SreeniEadara/Hopkins-iGEM-2022-electrical/iGEM.png

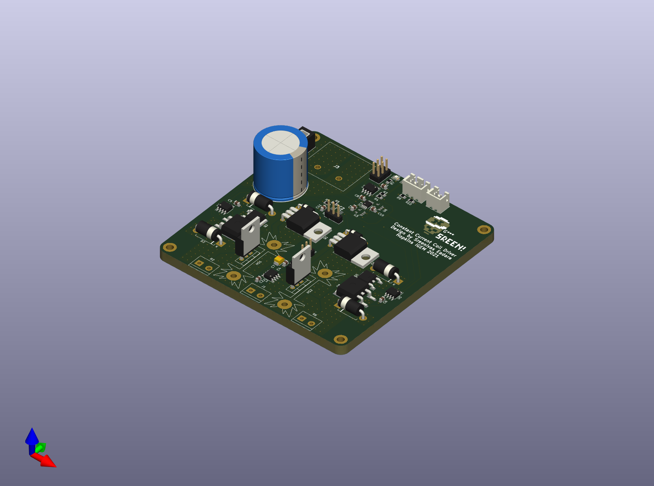
iGEM.png
