SreeniEadara/Hopkins-iGEM-2022-electrical/ConstantCurrentBoard.step

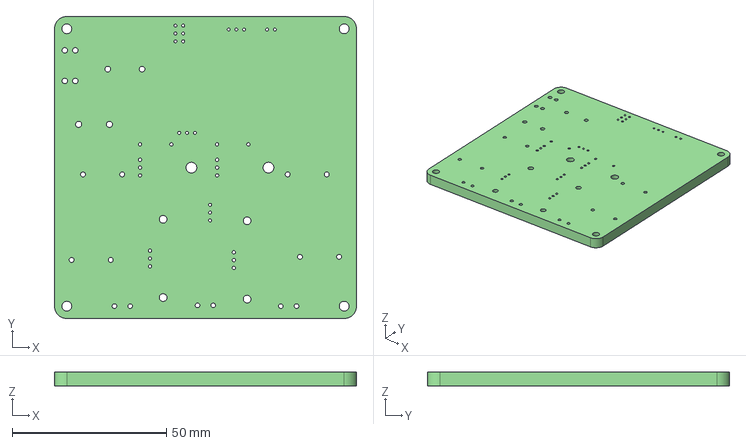
[picture p2: CAD file, 2022-08-01]
ConstantCurrentBoard.step
98.0 x 98.0 x 4.69 mm
