SreeniEadara/Hopkins-iGEM-2022-electrical/iGEM.kicad_pcb

## KiCad design iGEM.kicad_pcb (2022-09-10)

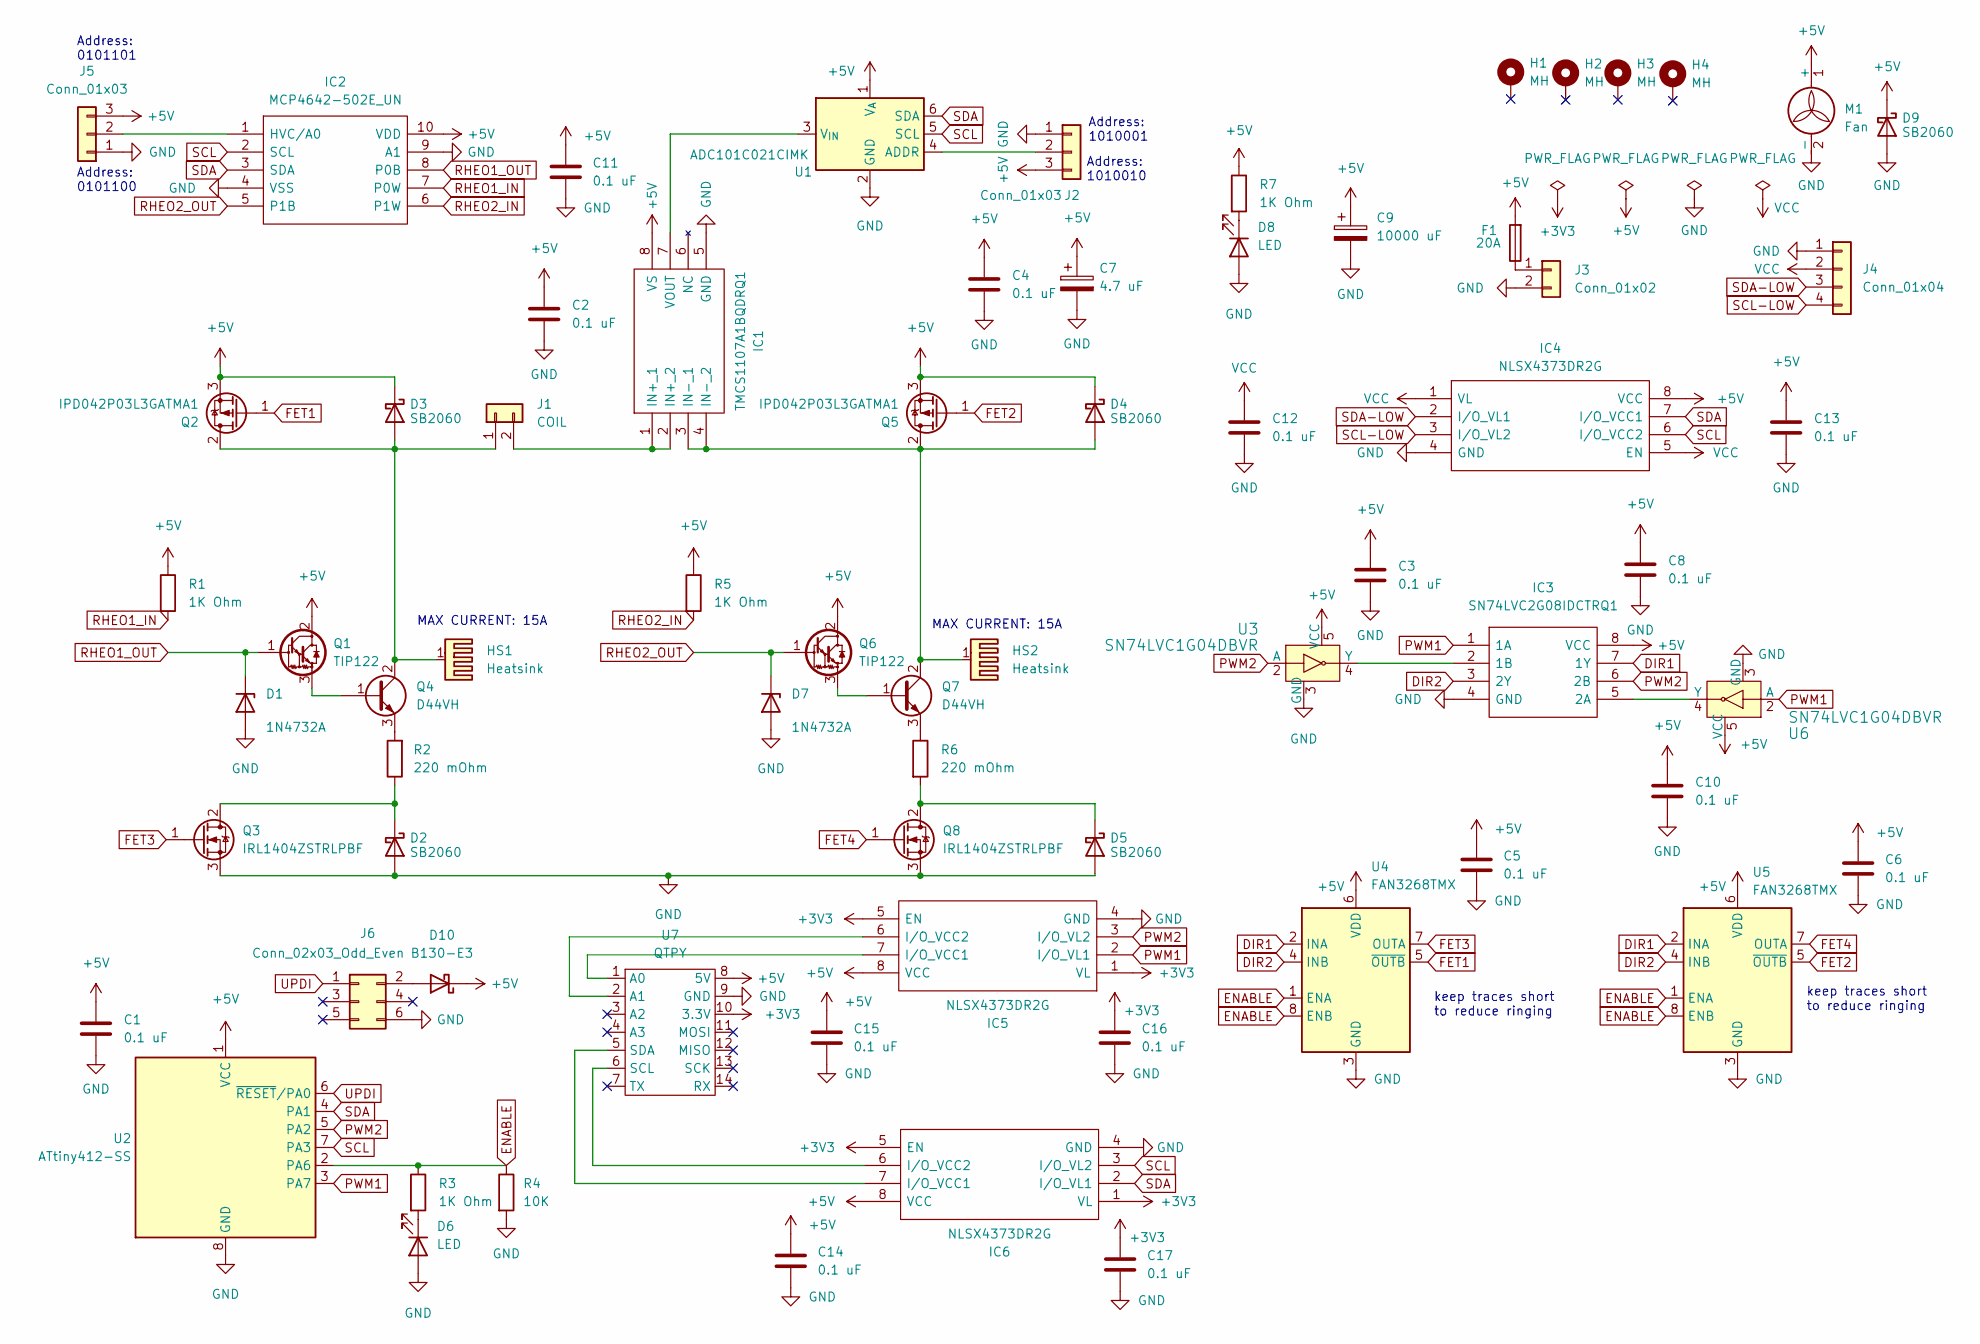
[picture p3: schematic iGEM.kicad_sch]

Parts:
C1, C2, C3, C4, C5, C6, C8, C10, C11, C12, C13, C14, C15, C16, C17: 0.1 uF; C_0805_2012Metric_Pad1.18x1.45mm_HandSolder; DigiKey 399-C0805C104K8RAC7800CT-ND
C7: 4.7 uF; CP_EIA-3528-21_Kemet-B_Pad1.50x2.35mm_HandSolder; DigiKey 399-3723-1-ND
C9: 10000 uF; CP_Radial_D22.0mm_P10.00mm_SnapIn; DigiKey 399-ELG109M025AQ4AA-ND
D1, D7: 1N4732A; D_DO-41_SOD81_P10.16mm_Horizontal; DigiKey 1N4732AFSCT-ND
D2, D3, D4, D5, D9: SB2060; D_DO-201AD_P12.70mm_Horizontal; DigiKey 1655-SB2060CT-ND
D6, D8: LED; LED_0805_2012Metric_Pad1.15x1.40mm_HandSolder; DigiKey 475-1410-1-ND
D10: B130-E3; D_SMA; DigiKey B130-E3/5ATGICT-ND
F1: 20A; Fuseholder_Blade_Mini_Keystone_3568; DigiKey 36-3568-15-ND
H1, H2, H3, H4: MH; MountingHole_3.2mm_M3_DIN965_Pad
HS1, HS2: Heatsink; Heatsink_Fischer_SK104-STC-STIC_35x13mm_2xDrill2.5mm; DigiKey HS403-ND
IC1: TMCS1107A1BQDRQ1; SOIC-8_3.9x4.9mm_P1.27mm; Manufacturer_Part_Number TMCS1107A1BQDRQ1; DigiKey 296-TMCS1107A1BQDRQ1CT-ND
IC2: MCP4642-502E_UN; SOP50P490X110-10N; Manufacturer_Part_Number MCP4642-502E/UN; Mouser Part Number 579-MCP4642-502E/UN
IC3: SN74LVC2G08IDCTRQ1; MSOP-8_3x3mm_P0.65mm; Manufacturer_Part_Number SN74LVC2G08IDCTRQ1; Mouser Part Number 595-SN74LVC2G08IDCQ1
IC4, IC5, IC6: NLSX4373DR2G; SOIC-8_3.9x4.9mm_P1.27mm; Manufacturer_Part_Number NLSX4373DR2G; Mouser Part Number 863-NLSX4373DR2G
J1: COIL; TerminalBlock_bornier-2_P5.08mm; DigiKey 102-6218-ND
J2, J5: Conn_01x03; PinHeader_1x03_P2.54mm_Vertical
J3: Conn_01x02; 8PCV02006; DigiKey A98460-ND
J4: Conn_01x04; JST_XH_B4B-XH-A_1x04_P2.50mm_Vertical; DigiKey 455-2249-ND
J6: Conn_02x03_Odd_Even; PinHeader_2x03_P2.54mm_Vertical
M1: Fan; JST_XH_B2B-XH-A_1x02_P2.50mm_Vertical; DigiKey 455-2879-ND
Q1, Q6: TIP122; TO-220-3_Horizontal_TabDown; DigiKey TIP122GOS-ND
Q2, Q5: IPD042P03L3GATMA1; TO-252-2; DigiKey IPD042P03L3GATMA1CT-ND
Q3, Q8: IRL1404ZSTRLPBF; TO-263-2; DigiKey IRL1404ZSTRLPBFCT-ND
Q4, Q7: D44VH; TO-220-3_Vertical; DigiKey D44VH10GOS-ND
R1, R3, R5, R7: 1K Ohm; R_0805_2012Metric_Pad1.20x1.40mm_HandSolder; DigiKey CHP0805-FX-1001ELFCT-ND
R2, R6: 220 mOhm; TerminalBlock_bornier-2_P5.08mm; DigiKey A102180-ND
R4: 10K; R_0805_2012Metric_Pad1.20x1.40mm_HandSolder; DigiKey RMCF0805FT10K0CT-ND
U1: ADC101C021CIMK; SOT-23-6; DigiKey ADC101C021CIMK/NOPBCT-ND
U2: ATtiny412-SS; SOIC-8_3.9x4.9mm_P1.27mm; DigiKey ATTINY412-SSN-ND
U3, U6: SN74LVC1G04DBVR; SOT-753; MPN SN74LVC1G04DBVR; Digi-Key_PN 296-11599-1-ND
U4, U5: FAN3268TMX; SOIC-8_3.9x4.9mm_P1.27mm; DigiKey FAN3268TMXCT-ND
U7: QTPY; QTPY-RP2040

Connections:
+3V3: C16.1, C17.1, IC5.1 (VL), IC5.5 (EN), IC6.1 (VL), IC6.5 (EN), U7.10 (3.3V)
+5V: C1.1, C2.1, C3.1, C4.1, C5.1, C6.1, C7.1, C8.1, C9.1, C10.1, C11.1, C13.1, C14.1, C15.1, D3.1 (K), D4.1 (K), D9.1 (K), D10.1 (K), F1.2, IC1.8 (VS), IC2.10 (VDD), IC3.8 (VCC), IC4.8 (VCC), IC5.8 (VCC), IC6.8 (VCC), J2.3, J5.3, M1.1 (+), Q1.2 (C), Q2.3 (S), Q5.3 (S), Q6.2 (C), R1.1, R5.1, R7.1, U1.1 (V_{A}), U2.1 (VCC), U3.5 (VCC), U4.6 (VDD), U5.6 (VDD), U6.5 (VCC), U7.8 (5V)
DIR1: IC3.7 (1Y), U4.2 (INA), U5.2 (INA)
DIR2: IC3.3 (2Y), U4.4 (INB), U5.4 (INB)
ENABLE: R3.1, R4.1, U2.2 (PA6), U4.1 (ENA), U4.8 (ENB), U5.1 (ENA), U5.8 (ENB)
FET1: Q2.1 (G), U4.5 (~OUTB)
FET2: Q5.1 (G), U5.5 (~OUTB)
FET3: Q3.1 (G), U4.7 (OUTA)
FET4: Q8.1 (G), U5.7 (OUTA)
GND: C1.2, C2.2, C3.2, C4.2, C5.2, C6.2, C7.2, C8.2, C9.2, C10.2, C11.2, C12.2, C13.2, C14.2, C15.2, C16.2, C17.2, D1.2 (A), D2.2 (A), D5.2 (A), D6.2 (A), D7.2 (A), D8.2 (A), D9.2 (A), IC1.5 (GND), IC2.4 (VSS), IC2.9 (A1), IC3.4 (GND), IC4.4 (GND), IC5.4 (GND), IC6.4 (GND), J2.1, J3.2, J4.1, J5.1, J6.6, M1.2 (-), Q3.3 (S), Q8.3 (S), R4.2, U1.2 (GND), U2.8 (GND), U3.3 (GND), U4.3 (GND), U5.3 (GND), U6.3 (GND), U7.9 (GND)
unnamed: D2.1 (K), Q3.2 (D), R2.1
unnamed: D3.2 (A), HS1.1, J1.1, Q2.2 (D), Q4.2 (C)
unnamed: D4.2 (A), HS2.1, IC1.3 (IN-_1), IC1.4 (IN-_2), Q5.2 (D), Q7.2 (C)
unnamed: D5.1 (K), Q8.2 (D), R6.2
unnamed: D6.1 (K), R3.2
unnamed: D8.1 (K), R7.2
unnamed: D10.2 (A), J6.2
unnamed: F1.1, J3.1
unnamed: IC1.1 (IN+_1), IC1.2 (IN+_2), J1.2
unnamed: IC1.7 (VOUT), U1.3 (V_{IN})
unnamed: IC2.1 (HVC/A0), J5.2
unnamed: IC3.2 (1B), U3.4 (Y)
unnamed: IC3.5 (2A), U6.4 (Y)
unnamed: IC5.6 (I/O_VCC2), U7.2 (A1)
unnamed: IC5.7 (I/O_VCC1), U7.1 (A0)
unnamed: IC6.6 (I/O_VCC2), U7.6 (SCL)
unnamed: IC6.7 (I/O_VCC1), U7.5 (SDA)
unnamed: J2.2, U1.4 (ADDR)
unnamed: Q1.3 (E), Q4.1 (B)
unnamed: Q4.3 (E), R2.2
unnamed: Q6.3 (E), Q7.1 (B)
unnamed: Q7.3 (E), R6.1
PWM1: IC3.1 (1A), IC5.2 (I/O_VL1), U2.3 (PA7), U6.2 (A)
PWM2: IC3.6 (2B), IC5.3 (I/O_VL2), U2.5 (PA2), U3.2 (A)
RHEO1_IN: IC2.7 (P0W), R1.2
RHEO1_OUT: D1.1 (K), IC2.8 (P0B), Q1.1 (B)
RHEO2_IN: IC2.6 (P1W), R5.2
RHEO2_OUT: D7.1 (K), IC2.5 (P1B), Q6.1 (B)
SCL: IC2.2 (SCL), IC4.6 (I/O_VCC2), IC6.3 (I/O_VL2), U1.5 (SCL), U2.7 (PA3)
SCL-LOW: IC4.3 (I/O_VL2), J4.4
SDA: IC2.3 (SDA), IC4.7 (I/O_VCC1), IC6.2 (I/O_VL1), U1.6 (SDA), U2.4 (PA1)
SDA-LOW: IC4.2 (I/O_VL1), J4.3
UPDI: J6.1, U2.6 (~RESET/PA0)
VCC: C12.1, IC4.1 (VL), IC4.5 (EN), J4.2

Notes on the sheet:
Address: 0101101
MAX CURRENT: 15A
keep traces short to reduce ringing
Address: 1010001
Address: 1010010
Address: 0101100

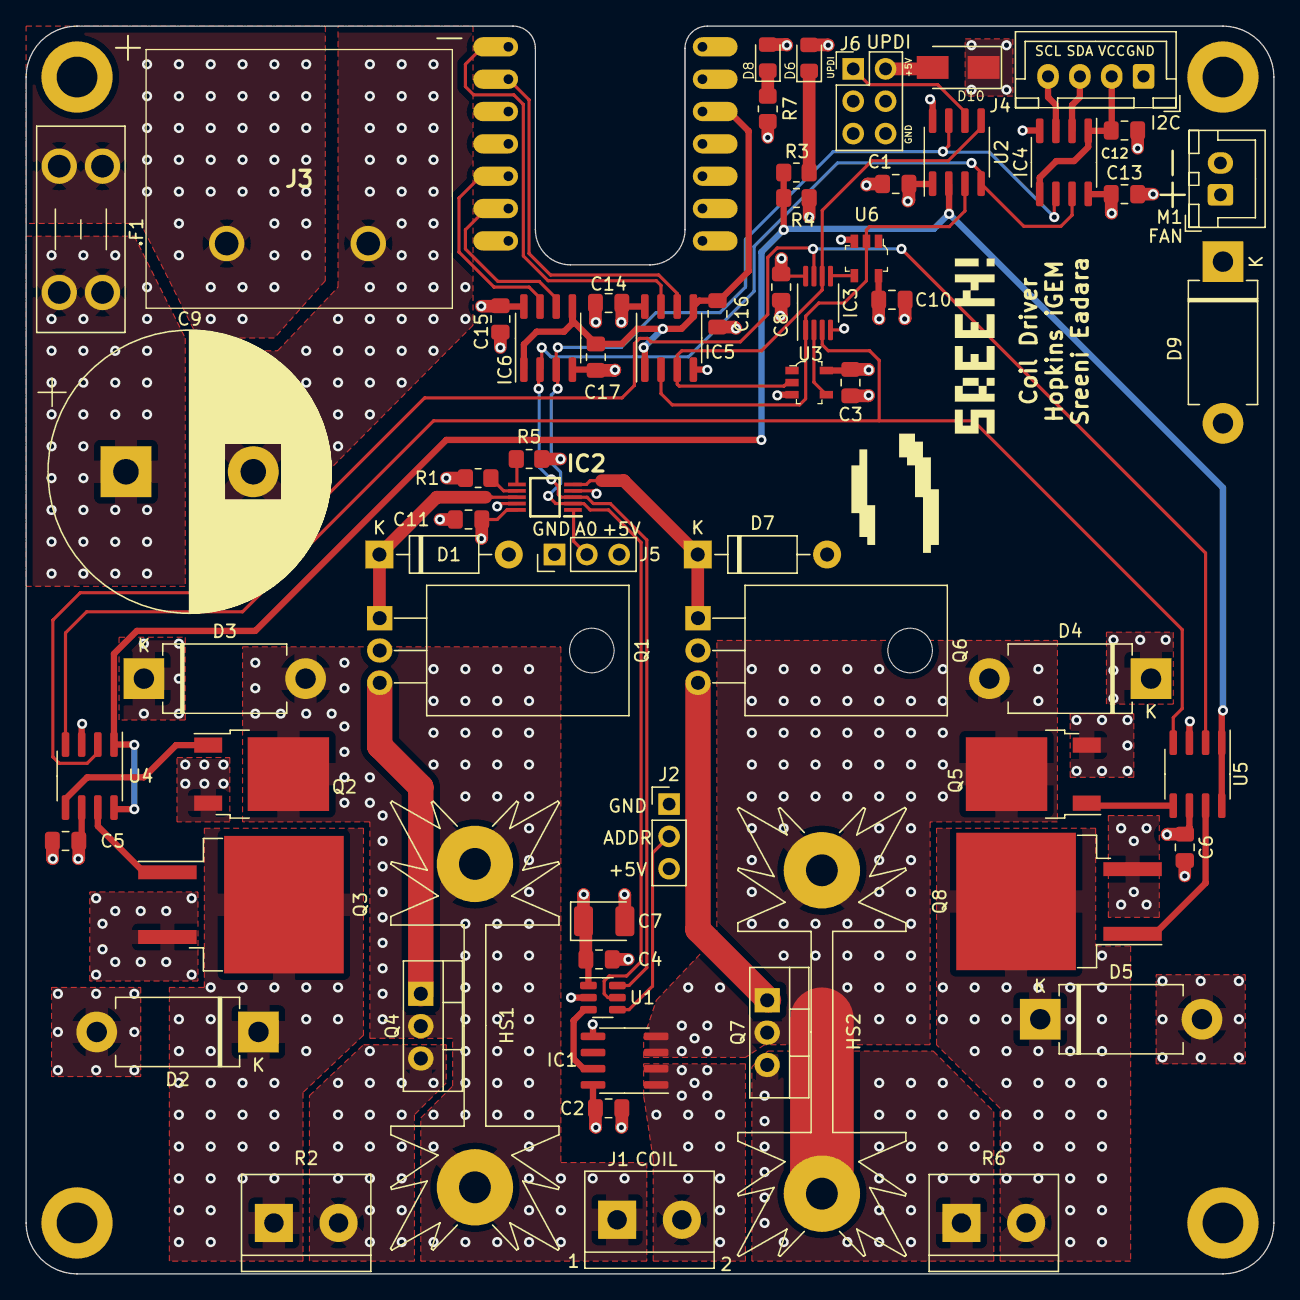
[picture p4: board iGEM.kicad_pcb from above]

Board: 4 copper layers, 98.0 x 98.0 mm, 69 parts (0 on the bottom side), 44 nets.
