SreeniEadara/Hopkins-iGEM-2022-electrical/(commit log)

2022-06-11 initial commit. Schematic not yet complete
    [iGEM.kicad_pcb, iGEM.kicad_sch]
2022-06-11 updated schematic. Added symbols for Adafruit Trinket
    [iGEM.kicad_sch]
2022-07-04 Updated schematic using simulation results and common resistor values. Now using an NPN darlington to drive a D44VH
    [iGEM.kicad_sch]
2022-07-04 changes made to satisfy ERC
    [iGEM.kicad_sch]
2022-07-05 Schematics capture complete. Added footprints and DigiKey part numbers
    [iGEM.kicad_pcb, iGEM.kicad_sch]
2022-07-05 layout draft complete
    [iGEM.kicad_pcb, iGEM.kicad_sch]
2022-07-05 updated DigiKey part numbers and value of i2c pullups
    [iGEM.kicad_sch]
2022-07-06 cosmetic changes. added designer name
    [iGEM.kicad_pcb]
2022-07-06 Added PCA9536D address
    [iGEM.kicad_sch]
2022-07-06 mounting holes no longer connected to signal ground because the chassis will be connected to true earth
    [iGEM.kicad_pcb, iGEM.kicad_sch]
2022-07-07 updated mounting holes to M3
    [iGEM.kicad_pcb, iGEM.kicad_sch]
2022-07-07 layout cleanup
    [iGEM.kicad_pcb]
2022-07-14 increased current capacity and added useful silk
    [ConstantCurrentBoard.step, iGEM.kicad_pcb, iGEM.kicad_sch]
2022-07-18 Changed to a single H-bridge for a single coil. Many parts changes. Addresses now configurable via pin header
    [iGEM.kicad_pcb, iGEM.kicad_sch]
2022-07-18 Added indicator LED and updated resistor value
    [iGEM.kicad_sch]
2022-07-18 added bulk capacitance and bug fixes
    [iGEM.kicad_sch]
2022-07-20 Changes to improve thermals and layout
    [iGEM.kicad_pcb, iGEM.kicad_sch]
2022-07-21 update layout and heatsink
    [iGEM.kicad_pcb, iGEM.kicad_sch]
2022-07-21 Update silk and component position to satisfy ERC
    [iGEM.kicad_pcb]
2022-07-22 changing from 6 to 4 layer board. 6 layers is too expensive
    [iGEM.kicad_pcb]
2022-07-23 Added LOGOS
    [iGEM-B_Cu.gbr, iGEM-B_Mask.gbr, iGEM-B_Paste.gbr, iGEM-B_Silkscreen.gbr, iGEM-Edge_Cuts.gbr, iGEM-F_Cu.gbr, iGEM-F_Mask.gbr, iGEM-F_Paste.gbr]
2022-07-24 Update LOGO to satisfy DRC
    [iGEM.kicad_pcb]
2022-07-24 Adding BOM 'iGEM.csv'
    [iGEM.csv, iGEM.kicad_sch]
2022-07-24 Adding DigiKey cart csv for ease of purchase. Current total 58.60
    [DigiKey_Cart.csv]
2022-07-27 MAJOR LOGIC BUG FIX. Layout also altered
    [iGEM.kicad_pcb, iGEM.kicad_sch]
2022-08-01 changed copper pours. Updated BOM and STEP and removed outdated manufacturing files
    [ConstantCurrentBoard.step, DigiKey_Cart.csv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]
2022-08-02 miscellaneous changes and cleanup
    [iGEM.kicad_pcb]
2022-08-03 Fixed silk
    [iGEM.kicad_pcb]
2022-08-05 Added more vias for heat dissipation
    [iGEM.kicad_pcb]
2022-08-09 update layout
    [iGEM.kicad_pcb]
2022-08-13 adding extra vias for heat dissipation
    [iGEM.kicad_pcb]
2022-08-18 Adding level shifter
    [iGEM.kicad_pcb, iGEM.kicad_sch]
2022-08-20 Added useful silk and moved fan connector
    [iGEM.kicad_pcb]
2022-08-21 Adding inductor to prevent fan voltage spikes
    [iGEM.kicad_pcb, iGEM.kicad_sch]
2022-08-23 Adding programming power protection
    [iGEM.kicad_pcb, iGEM.kicad_sch]
2022-08-23 updated to include programming power protection and cleanup
    [iGEM.kicad_pcb, iGEM.kicad_sch]
2022-08-24 Improved copper balance and cleanup
    [iGEM.kicad_pcb]
2022-08-24 adding PCB with curved tracks for style points B) thanks mitxela
    [iGEM-melty.kicad_pcb]
2022-08-26 Replace out of stock Stemma QT header
    [iGEM-melty.kicad_pcb, iGEM.csv, iGEM.kicad_pcb, iGEM.kicad_sch]
2022-08-29 miscellaneous improvements and cleanup
    [DigiKey_Cart.csv, iGEM-melty.kicad_pcb, iGEM.csv, iGEM.kicad_pcb]
2022-09-08 Adding QTPY RP2040 as a backup if ATTiny412 does not work
    [iGEM.kicad_pcb, iGEM.kicad_sch]
2022-09-10 adding layout with RP2040 QTPY
    [iGEM.kicad_pcb, iGEM.kicad_sch]
2022-09-10 updated for clearances
    [iGEM.kicad_pcb]
